BiOflab/zIncubascope/code/aggregate size detection_yeast/Montage_vid-2.tif

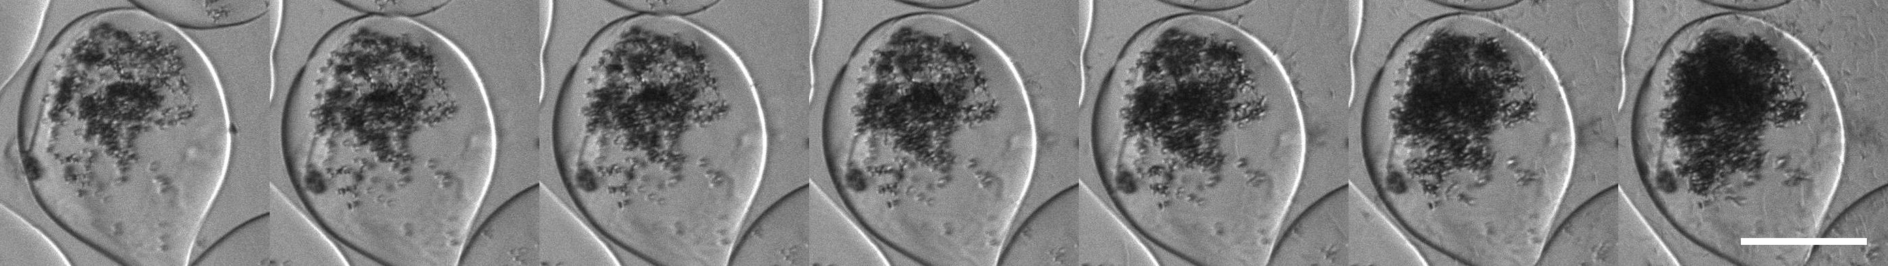
code/aggregate size detection_yeast/Montage_vid-2.tif
