BiOflab/zIncubascope/code/aggregate size detection_yeast/analysis_mask_caps1/frame_1.tif

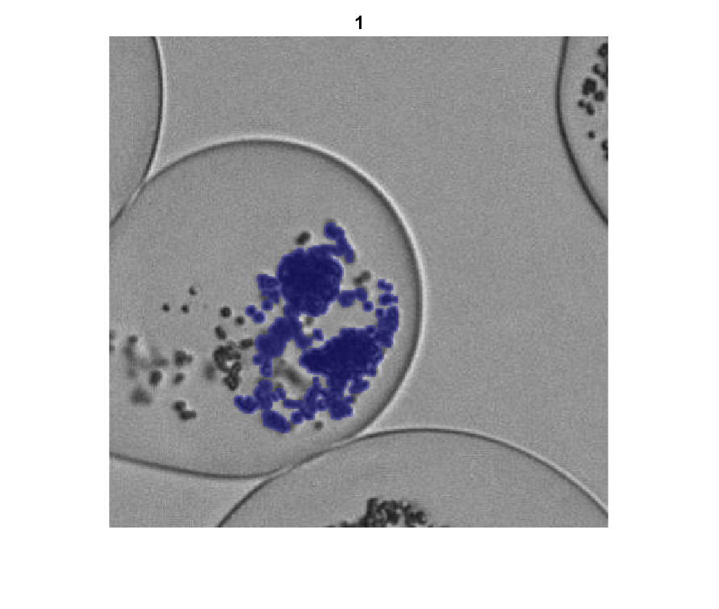
code/aggregate size detection_yeast/analysis_mask_caps1/frame_1.tif
