BiOflab/zIncubascope/code/aggregate size detection_yeast/analysis_mask_caps1/frame_50.tif

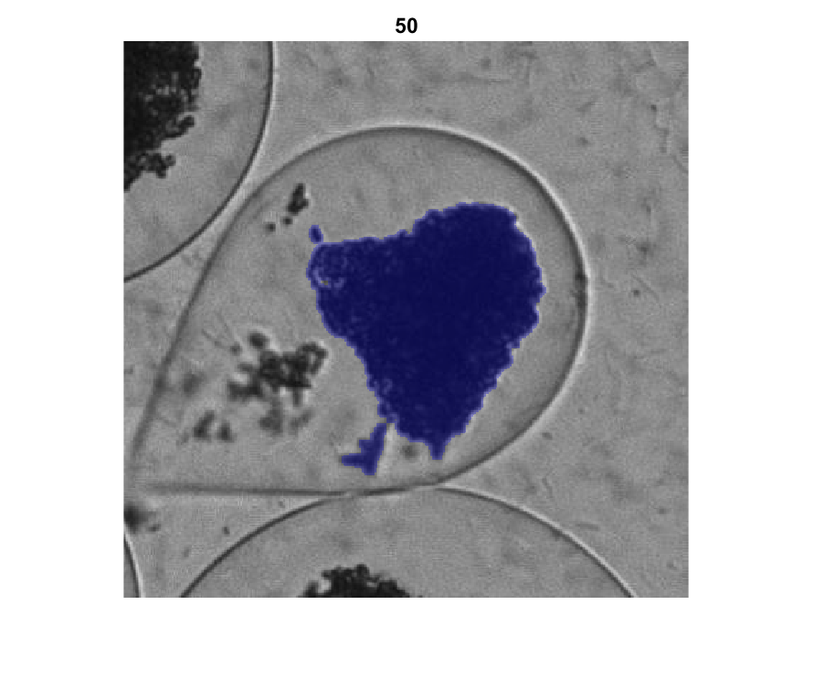
code/aggregate size detection_yeast/analysis_mask_caps1/frame_50.tif
