BiOflab/zIncubascope/code/cyst thickness detection_capsule/analyzed frames/frame_6.tif

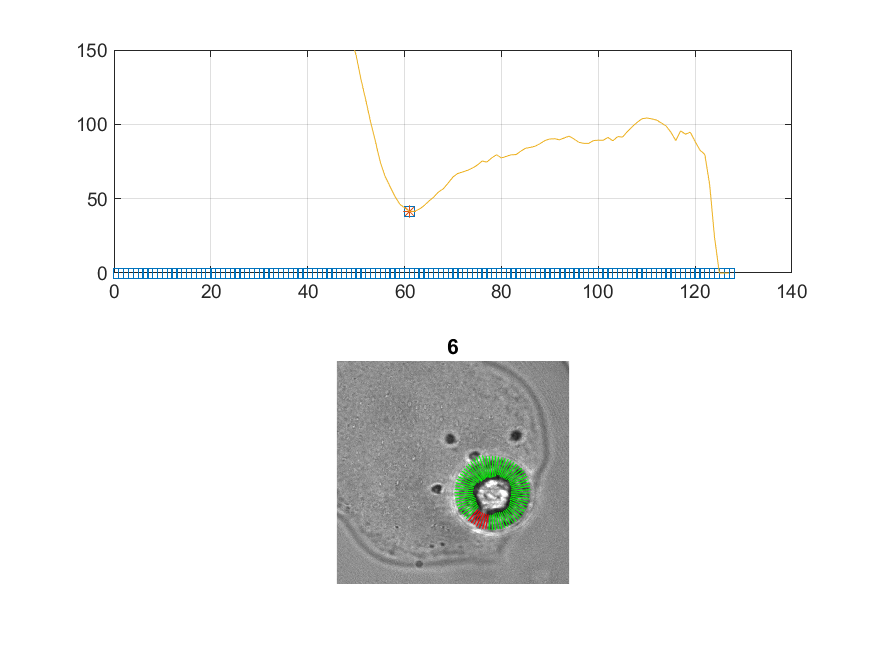
code/cyst thickness detection_capsule/analyzed frames/frame_6.tif
