BiOflab/zIncubascope/code/cyst thickness detection_tubes/Combined_analyzed images/frame_6.tif

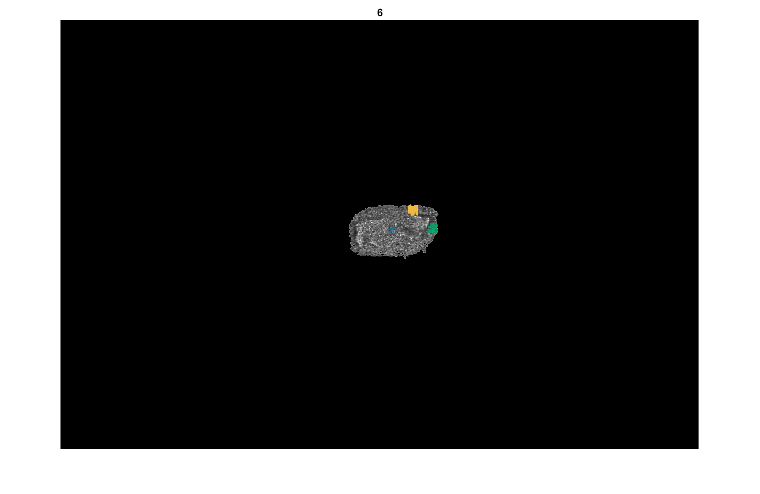
code/cyst thickness detection_tubes/Combined_analyzed images/frame_6.tif
