BiOflab/zIncubascope/3Dprinted_parts/CAD_files/25mm micrometer_gear head_V1.SLDPRT

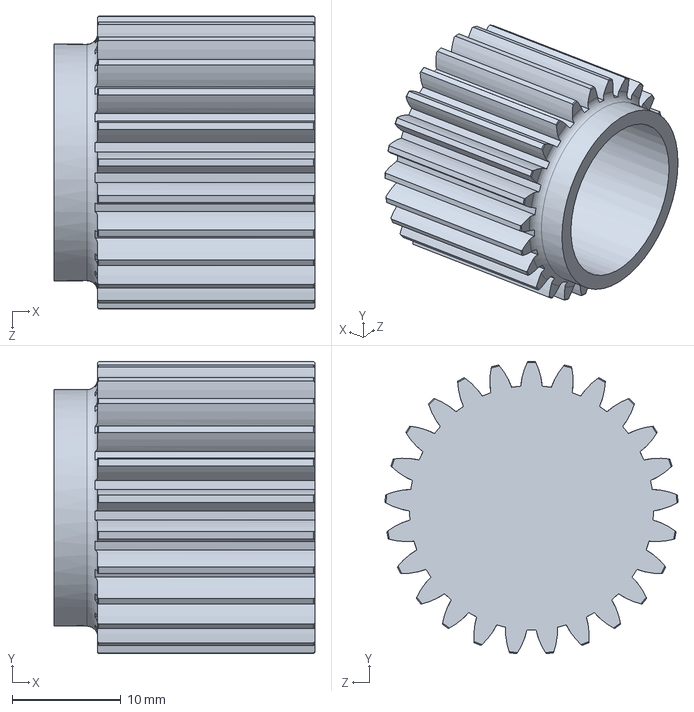
[picture p9: CAD file, 2024-02-28]
3Dprinted_parts/CAD_files/25mm micrometer_gear head_V1.SLDPRT
24.0 x 26.9 x 27.0 mm
