BiOflab/zIncubascope/3Dprinted_parts/STL_files/sample_holder_multi-size_V1.STL

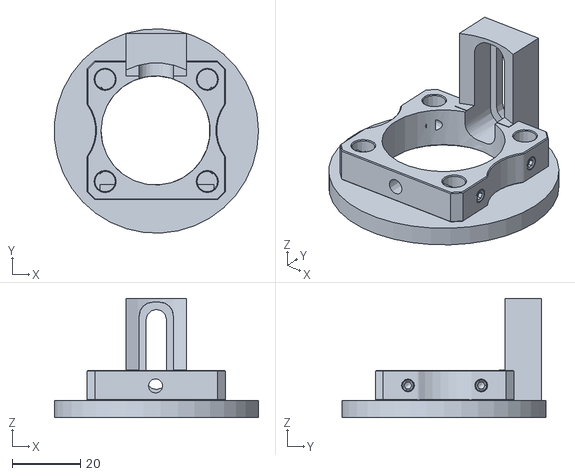
[picture p10: CAD file, 2024-02-28]
3Dprinted_parts/STL_files/sample_holder_multi-size_V1.STL
59.9 x 59.9 x 35.0
