BiOflab/zIncubascope/3Dprinted_parts/CAD_files/36mm motor_gear_V1.SLDPRT

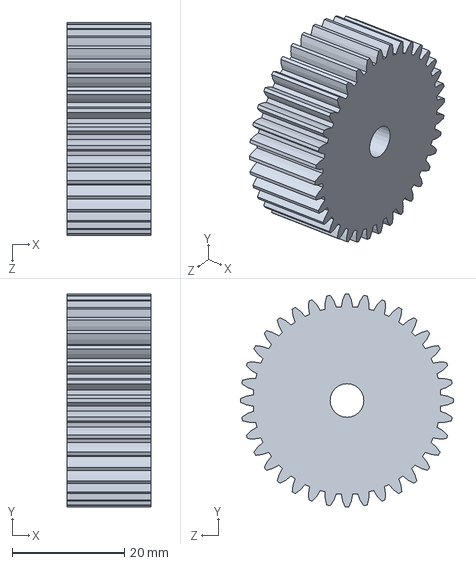
[picture p11: CAD file, 2024-02-28]
3Dprinted_parts/CAD_files/36mm motor_gear_V1.SLDPRT
15.0 x 38.0 x 38.0 mm
