BiOflab/zIncubascope/(list of files, cad)

Other CAD files:
3Dprinted_parts/STL_files/25mm micrometer_gear head_V1.STL
3Dprinted_parts/STL_files/36mm motor_gear_V1.STL
