BiOflab/zIncubascope/code/aggregate size detection_yeast/Montage_vid-1.tif

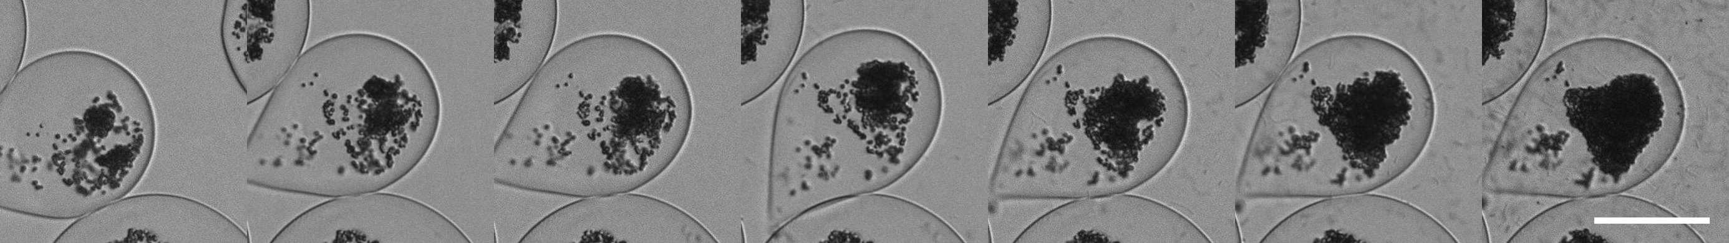
code/aggregate size detection_yeast/Montage_vid-1.tif
